schiantaberetti/ubertooth-mirror/README

Copyright 2010 Michael Ossmann

These files are part of Project Ubertooth.

This is a free hardware design; you can redistribute it and/or modify
it under the terms of the GNU General Public License as published by
the Free Software Foundation; either version 2, or (at your option)
any later version.

This design is distributed in the hope that it will be useful,
but WITHOUT ANY WARRANTY; without even the implied warranty of
MERCHANTABILITY or FITNESS FOR A PARTICULAR PURPOSE.  See the
GNU General Public License for more details.

You should have received a copy of the GNU General Public License
along with this design; see the file COPYING.  If not, write to
the Free Software Foundation, Inc., 51 Franklin Street,
Boston, MA 02110-1301, USA.

hardware notes:

Ubertooth One schematic and layout files were designed in KiCad, an open source
electronic design automation package.
