schiantaberetti/ubertooth-mirror/host/bluetooth_rxtx/ubertooth_interface.h

/*
 * Copyright 2012 Dominic Spill
 *
 * This file is part of Project Ubertooth.
 *
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
 * You should have received a copy of the GNU General Public License
 * along with this program; see the file COPYING.  If not, write to
 * the Free Software Foundation, Inc., 51 Franklin Street,
 * Boston, MA 02110-1301, USA.
 */

#ifndef __UBERTOOTH_INTERFACE_H
#define __UBERTOOTH_INTERFACE_H

#define DMA_SIZE 50

enum ubertooth_usb_commands {
    UBERTOOTH_PING            = 0,
    UBERTOOTH_RX_SYMBOLS      = 1,
    UBERTOOTH_TX_SYMBOLS      = 2,
    UBERTOOTH_GET_USRLED      = 3,
    UBERTOOTH_SET_USRLED      = 4,
    UBERTOOTH_GET_RXLED       = 5,
    UBERTOOTH_SET_RXLED       = 6,
    UBERTOOTH_GET_TXLED       = 7,
    UBERTOOTH_SET_TXLED       = 8,
    UBERTOOTH_GET_1V8         = 9,
    UBERTOOTH_SET_1V8         = 10,
    UBERTOOTH_GET_CHANNEL     = 11,
    UBERTOOTH_SET_CHANNEL     = 12,
    UBERTOOTH_RESET           = 13,
    UBERTOOTH_GET_SERIAL      = 14,
    UBERTOOTH_GET_PARTNUM     = 15,
    UBERTOOTH_GET_PAEN        = 16,
    UBERTOOTH_SET_PAEN        = 17,
    UBERTOOTH_GET_HGM         = 18,
    UBERTOOTH_SET_HGM         = 19,
    UBERTOOTH_TX_TEST         = 20,
    UBERTOOTH_STOP            = 21,
    UBERTOOTH_GET_MOD         = 22,
    UBERTOOTH_SET_MOD         = 23,
    UBERTOOTH_SET_ISP         = 24,
    UBERTOOTH_FLASH           = 25,
    BOOTLOADER_FLASH          = 26,
    UBERTOOTH_SPECAN          = 27,
    UBERTOOTH_GET_PALEVEL     = 28,
    UBERTOOTH_SET_PALEVEL     = 29,
    UBERTOOTH_REPEATER        = 30,
    UBERTOOTH_RANGE_TEST      = 31,
    UBERTOOTH_RANGE_CHECK     = 32,
    UBERTOOTH_GET_REV_NUM     = 33,
    UBERTOOTH_LED_SPECAN      = 34,
    UBERTOOTH_GET_BOARD_ID    = 35,
    UBERTOOTH_SET_SQUELCH     = 36,
    UBERTOOTH_GET_SQUELCH     = 37,
    UBERTOOTH_SET_BDADDR      = 38,
    UBERTOOTH_START_HOPPING   = 39,
    UBERTOOTH_SET_CLOCK       = 40,
    UBERTOOTH_GET_CLOCK       = 41,
    UBERTOOTH_BTLE_SNIFFING   = 42,
    UBERTOOTH_GET_ACCESS_ADDRESS = 43,
    UBERTOOTH_SET_ACCESS_ADDRESS = 44,
    UBERTOOTH_DO_SOMETHING    = 45,
    UBERTOOTH_DO_SOMETHING_REPLY = 46,
    UBERTOOTH_GET_CRC_VERIFY  = 47,
    UBERTOOTH_SET_CRC_VERIFY  = 48,
    UBERTOOTH_POLL            = 49,
    UBERTOOTH_BTLE_PROMISC    = 50,
    UBERTOOTH_SET_AFHMAP      = 51,
	UBERTOOTH_CLEAR_AFHMAP    = 52,
		UBERTOOTH_INQUIRY_SCAN = 100,
		UBERTOOTH_INQ_JAM = 101,
		UBERTOOTH_BT_JAM = 102,
};

enum modulations {
	MOD_BT_BASIC_RATE = 0,
	MOD_BT_LOW_ENERGY = 1,
	MOD_80211_FHSS    = 2
};

enum operating_modes {
	MODE_IDLE          = 0,
	MODE_RX_SYMBOLS    = 1,
	MODE_TX_SYMBOLS    = 2,
	MODE_TX_TEST       = 3,
	MODE_SPECAN        = 4,
	MODE_RANGE_TEST    = 5,
	MODE_REPEATER      = 6,
	MODE_LED_SPECAN    = 7,
	MODE_BT_FOLLOW     = 8,
	MODE_BT_FOLLOW_LE  = 9,
	MODE_BT_PROMISC_LE = 10,
	MODE_RESET         = 11,
	MODE_INQUIRY         = 12,
	MODE_JAM = 13,
};

enum usb_pkt_types {
	BR_PACKET  = 0,
	LE_PACKET  = 1,
	MESSAGE    = 2,
	KEEP_ALIVE = 3,
};

/*
 * USB packet for Bluetooth RX (64 total bytes)
 */
typedef struct {
	u8     pkt_type;
	u8     status;
	u8     channel;
	u8     clkn_high;
	u32    clk100ns;
	char   rssi_max;   // Max RSSI seen while collecting symbols in this packet
	char   rssi_min;   // Min ...
	char   rssi_avg;   // Average ...
	u8     rssi_count; // Number of ... (0 means RSSI stats are invalid)
	u8     reserved[2];
	u8     data[DMA_SIZE];
} usb_pkt_rx;

typedef struct {
	u64    address;
	u64    access_code;
} bdaddr;

typedef struct {
	u8 valid;
	u8 request_pa;
	u8 request_num;
	u8 reply_pa;
	u8 reply_num;
} rangetest_result;

#endif /* __UBERTOOTH_INTERFACE_H */
