schiantaberetti/ubertooth-mirror/(commit log)

2010-11-04 initial kicad files
    [ubertooth-one.sch]
2010-11-04 LPC175x symbol
    [ubertooth-one.sch]
2010-11-05 CC2400, CC2591
    [ubertooth-one.sch]
2010-11-11 ubertooth one schematic
    [ubertooth-one.sch]
2010-11-11 revision tagging
    [ubertooth-one.sch]
2010-11-11 more tagging
    [ubertooth-one.sch]
2010-11-11 ubertooth one layout (empty)
    [ubertooth-one.brd, ubertooth-one.sch]
2010-11-13 pogoprog: an ubertooth programmer
    [ubertooth-one.brd]
2010-11-15 ubertooth one layout complete this is an attempt at a two layer board - it will probably turn into four layers
    [ubertooth-one.brd, ubertooth-one.sch]
2010-11-15 rev stamp
    [ubertooth-one.brd]
2010-11-15 silkscreen tweak
    [ubertooth-one.brd]
2010-11-15 fixed zone cutouts
    [ubertooth-one.brd]
2010-12-01 ubertooth one tweaks
    [ubertooth-one.brd, ubertooth-one.sch]
2010-12-01 redo zone fill
    [ubertooth-one.brd]
2010-12-01 silkscreen fix
    [ubertooth-one.brd]
2011-08-19 started Broccoli/CC2400 contingency schematic
    [broccoli.sch]
2011-08-24 Broccoli/CC2400: added 1V8 regulator, clock distribution, big cap for power switching
    [broccoli.sch]
2011-08-24 Broccoli/CC2400: ATEST connections, test points, fixed missing 1V8 supply on CC2400
    [broccoli.sch]
2011-08-24 Broccoli/CC2400: minor schematic/BOM tweaks
    [broccoli.sch]
2011-08-24 Broccoli/CC2400: BOM updates
    [broccoli.sch]
2013-04-16 fix a bug in cmd_start_hopping.
    [ubertooth_control.c]
