schiantaberetti/ubertooth-mirror/(notices)

Notices in the files:
ubertooth-one.sch:
License: GPL v2, http://ubertooth.sourceforge.net
